Roluda/MachtGoethe/Info_Datasheets/nano_pinout.jpg

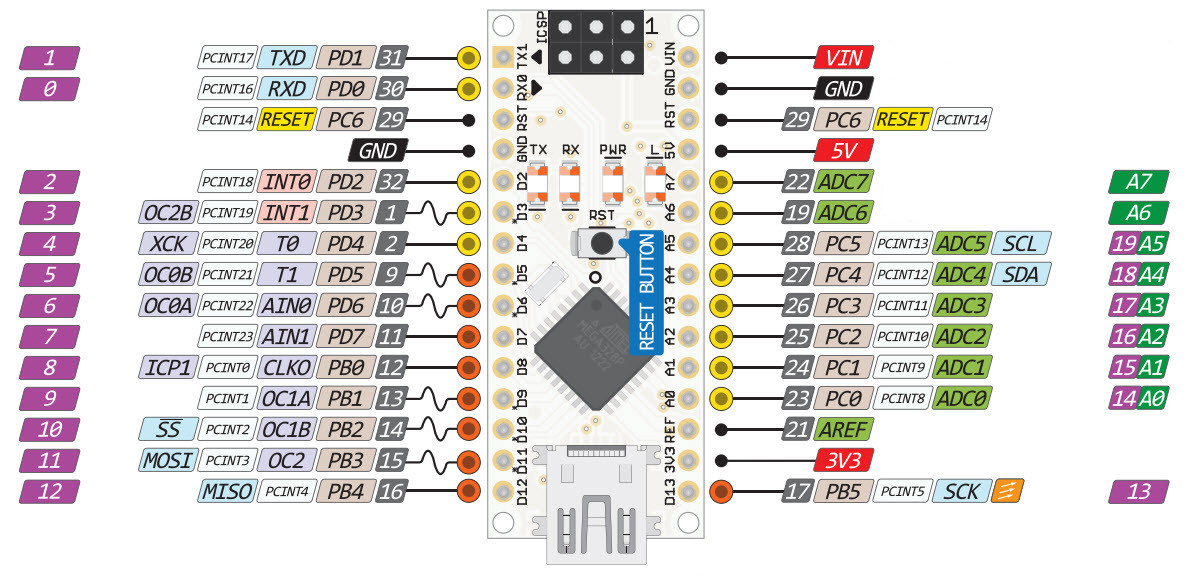
Info_Datasheets/nano_pinout.jpg
