Roluda/MachtGoethe/README.md

# MachtGoethe
Arduino Sketche und Schaltpläne für "Escape the Library"

Die Grundstruktur des Buches ist im Buch_Schaltplan.pdf abgebildet.

Mehr Details zu spezifischen Rätseln finden sich in den "schemes" Ordnern der Rätsel.

Die Sketche für die Arduinos sind in den "firmware" Ordnern zu finden.
