Roluda/MachtGoethe/Seite01_RFID-Edelsteindetektor/Kuehlkoerper/RFID_KK.pdf

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

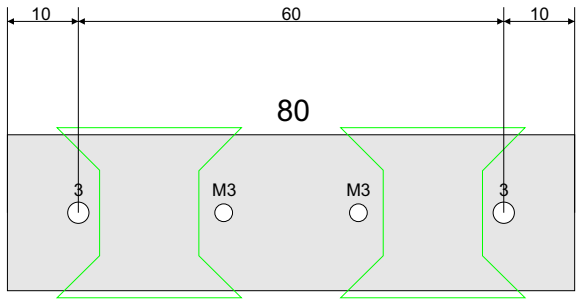
[picture p2: figure]
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
