Roluda/MachtGoethe/Seite01_RFID-Edelsteindetektor/schematics/Goethe_RFID_partlist.xls

 | Partlist
 | Exported from Goethe_RFID_v2.sch at 17.01.2020 02:36
 | EAGLE Version 7.7.0 Copyright (c) 1988-2016 CadSoft |  |  | Device count | 8
Count | Value | Device | Package | Order no | Total count
7 | 10u | C-EUC1206 | C1206 | X7R-G1206 10/25 | 56 | vorhanden
1 | SS1XL | SS1XL | SUB_SMA | SS 12L | 8 | vorhanden
1 | LM1086 | VREG_TO220L_A | TO220L1 | LM 1086 CT-ADJ | 8
1 | LM2937 | VREG_SOT223 | SOT223 | LM 2937 IMP-3.3 | 8
1 | PINHD-1X3/90 | 1X03/90 | pinhead | SL 1x50w 2,54 | 8
6 | LED3MM_red | LED3MM | led | LED 3mm 2ma rt | 48
1 | LED3MM_green | LED3MM | led | LED 3mm 2ma gn | 8
1 | ARDUINO_R3_SMALL | ARDUINO_R3_SMALL | ARDUINOR3_SMALL | Aliexpress | 8
3 | IRF8910PBF | IRF8910PBF | SO-08 | IRF8910PBF | 24
8 | 1k | R-EU_R0805 | R0805 | SMD-0805 1,00k | 64
24 | 20/0.125W | R-EU_R0805 | R0805 | RND 0805 1 20 | 192
3 | 22k | R-EU_R0805 | R0805 | SMD-0805 22,0k | 24
1 | 100 | R-EU_R0805 | R0805 | SMD-0805 100 | 8
10 | 220 | R-EU_R0805 | R0805 | SMD-0805 220 | 80
1 | 860 | R-EU_R0805 | R0805 | SMD-0805 860 | 8
1 | 0 | R-EU_R0805 | R0805 | SMD-0805 0,00 | 8
1 | ML16 | ML16 | con-harting-ml | WSL 16G | 8
1 | ML26 | ML26 | con-harting-ml | WSL 26G | 8
1 | 12V | supply | W237-02P | ASP 02 5 | 8
1 |  |  |  | AKL 330-02 | 8
5 |  |  |  | WSL 16W | 40
6 |  |  |  | PFL 16 | 48
1 |  |  |  | PFL 26 | 8
6 | 1n |  | bedrahtet 5mm | NPO-5 1,0N | 48
1 | Flachbandkabel |  |  | AWG 28-16G 10M
