Roluda/MachtGoethe/Seite01_RFID-Edelsteindetektor/Kuehlkoerper/RFID_KK.dxf

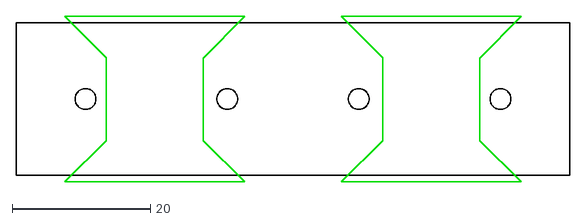
[picture p3: CAD file, 2020-01-26]
Seite01_RFID-Edelsteindetektor/Kuehlkoerper/RFID_KK.dxf
80.0 x 24.0
