Roluda/MachtGoethe/Seite01_Finale/schematics/Finale_Schaltplan.pdf

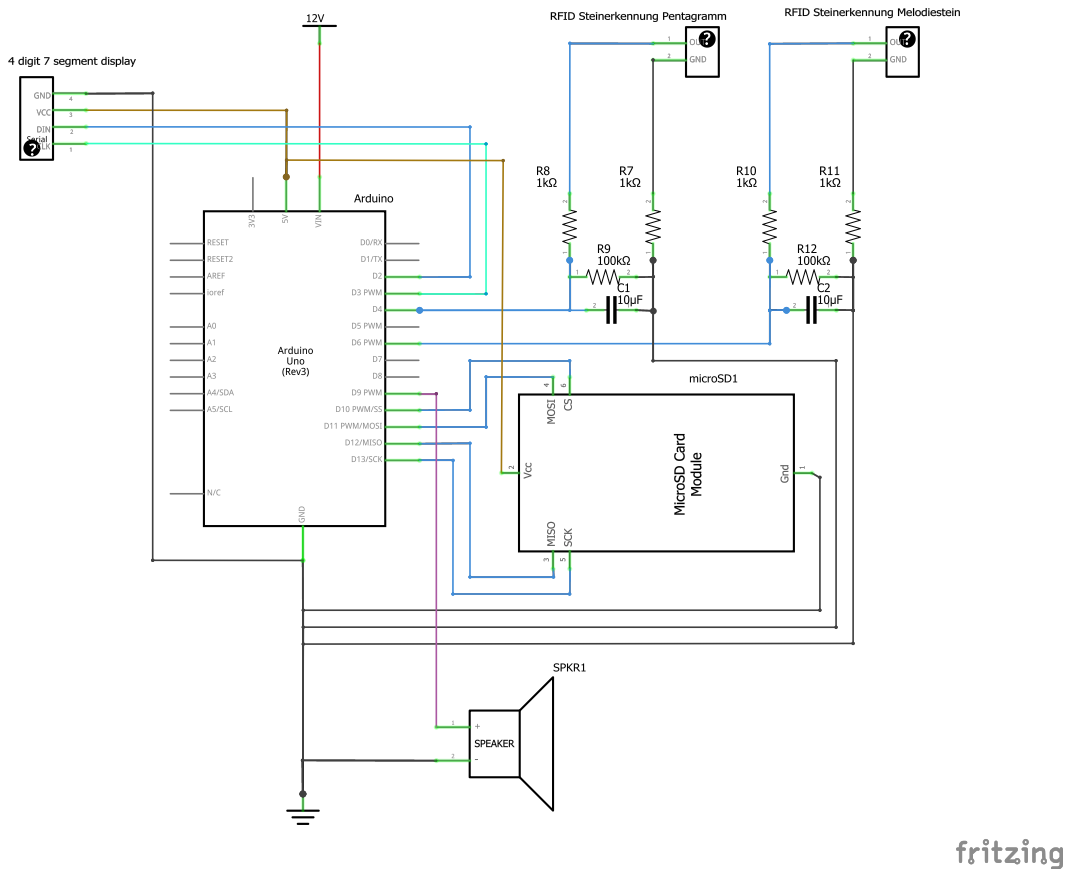
[picture p4: page 1]
