Roluda/MachtGoethe/Seite02_Klopfpuzzle/schematics/KlopfpuzzleSchaltplan.pdf

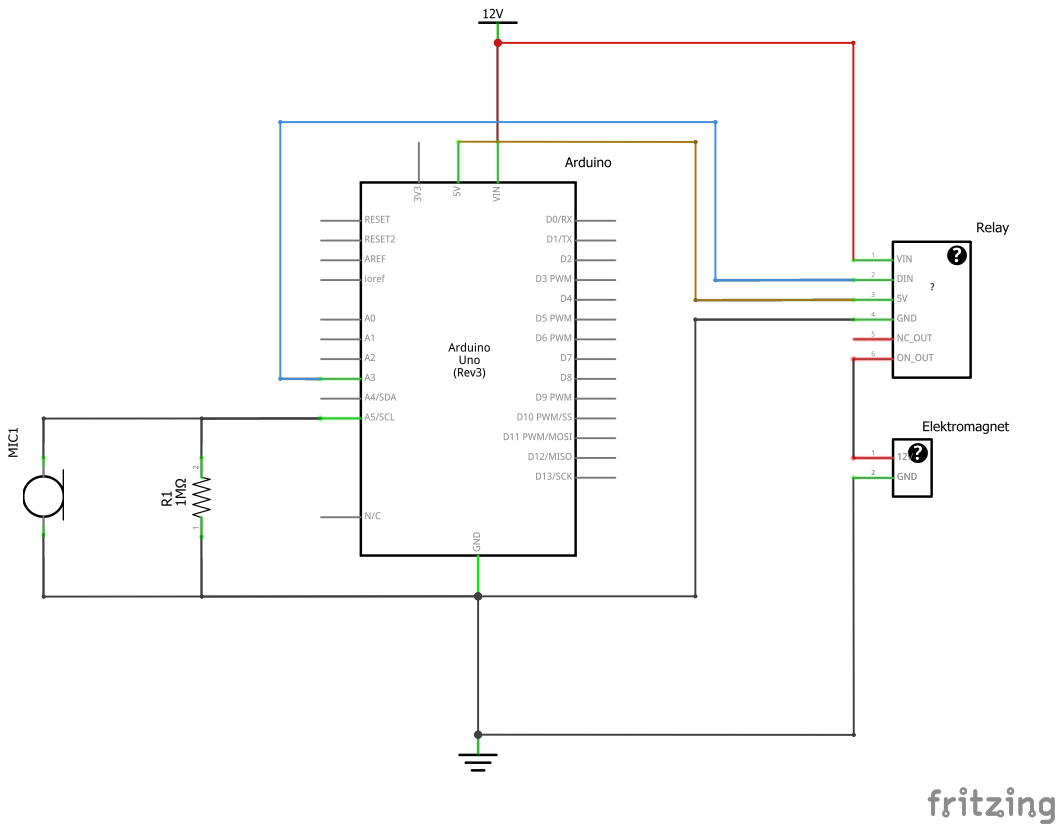
[picture p5: page 1]
