Roluda/MachtGoethe/Seite03_Farbkreispuzzle/schematics/Farbkreispuzzle_Schaltplan.pdf

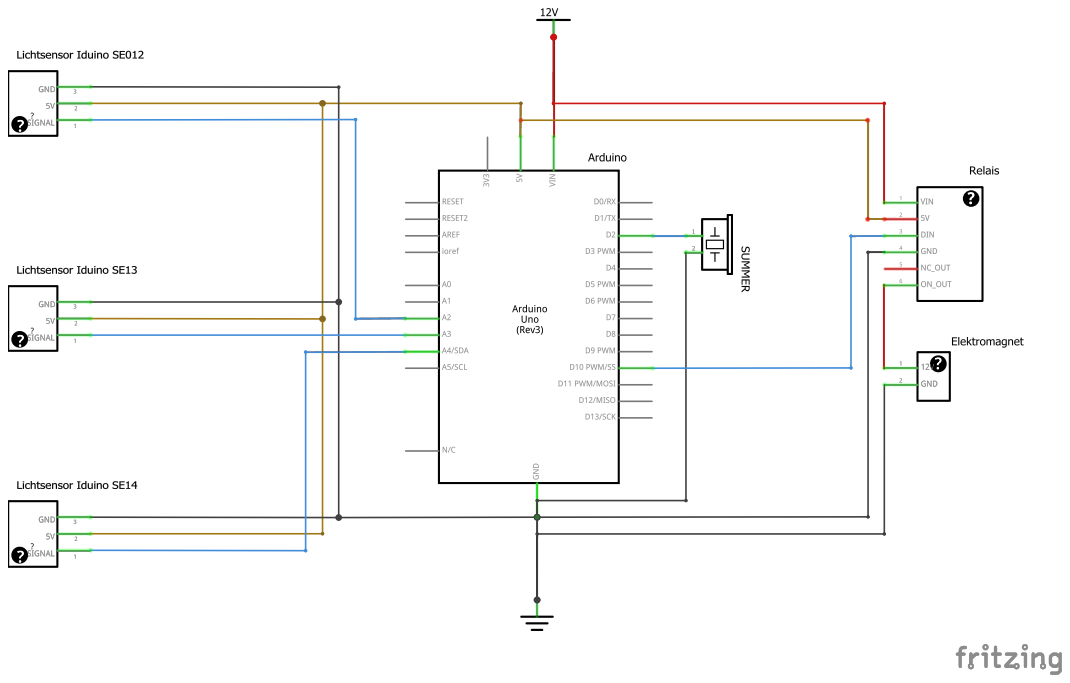
[picture p6: page 1]
