Roluda/MachtGoethe/Seite04_Endoskoppuzzle/schematics/Endoskoppuzzle_Schaltplan.pdf

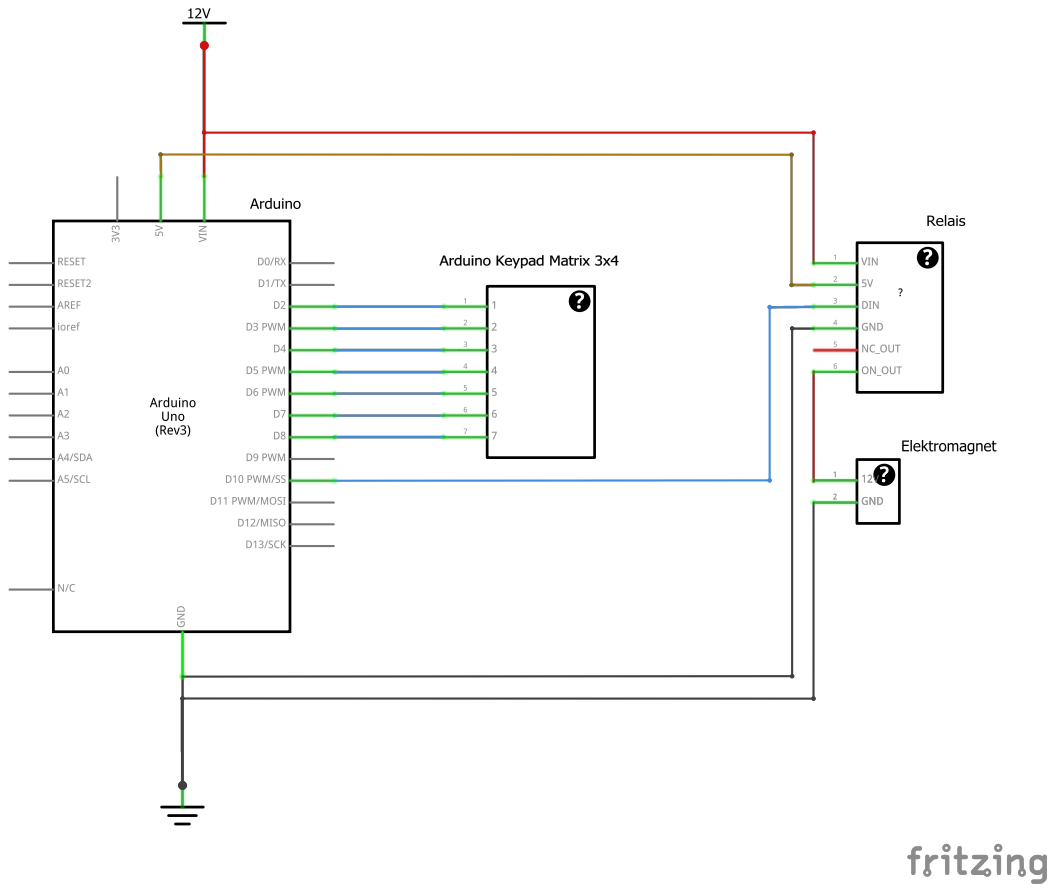
[picture p7: page 1]
