Roluda/MachtGoethe/Seite06_Steckpuzzle/schematics/Steckpuzzle_Schaltplan.pdf

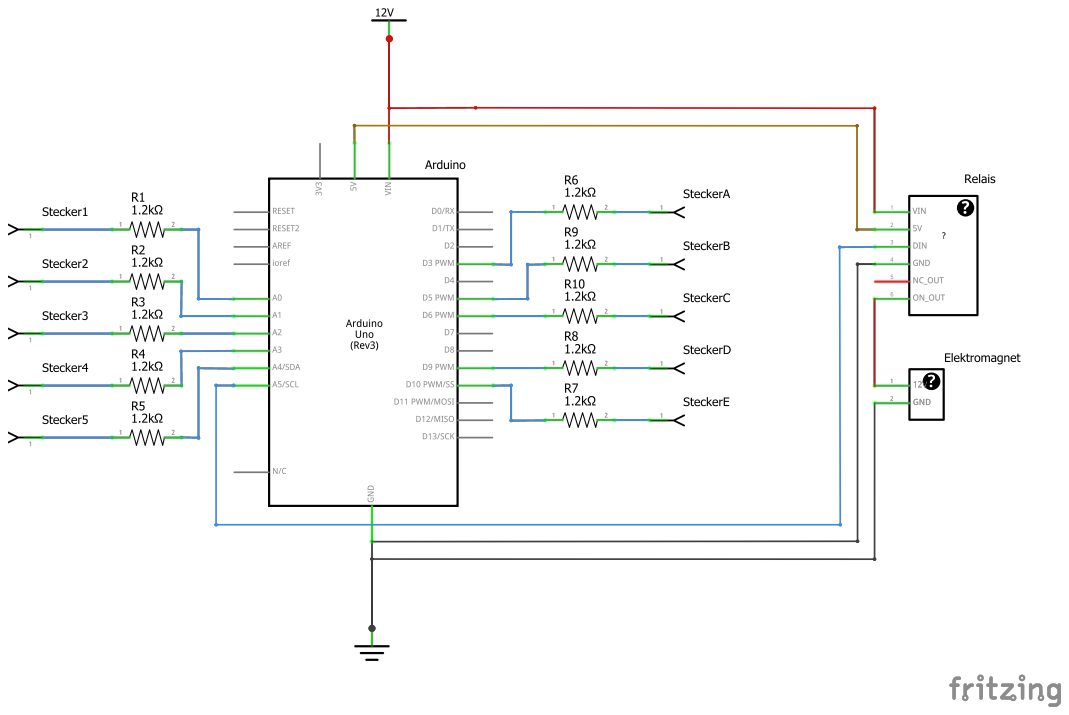
[picture p8: page 1]
