Roluda/MachtGoethe/Seite07_Melodiepuzzle/schematics/Melodiepuzzle_Schaltplan.pdf

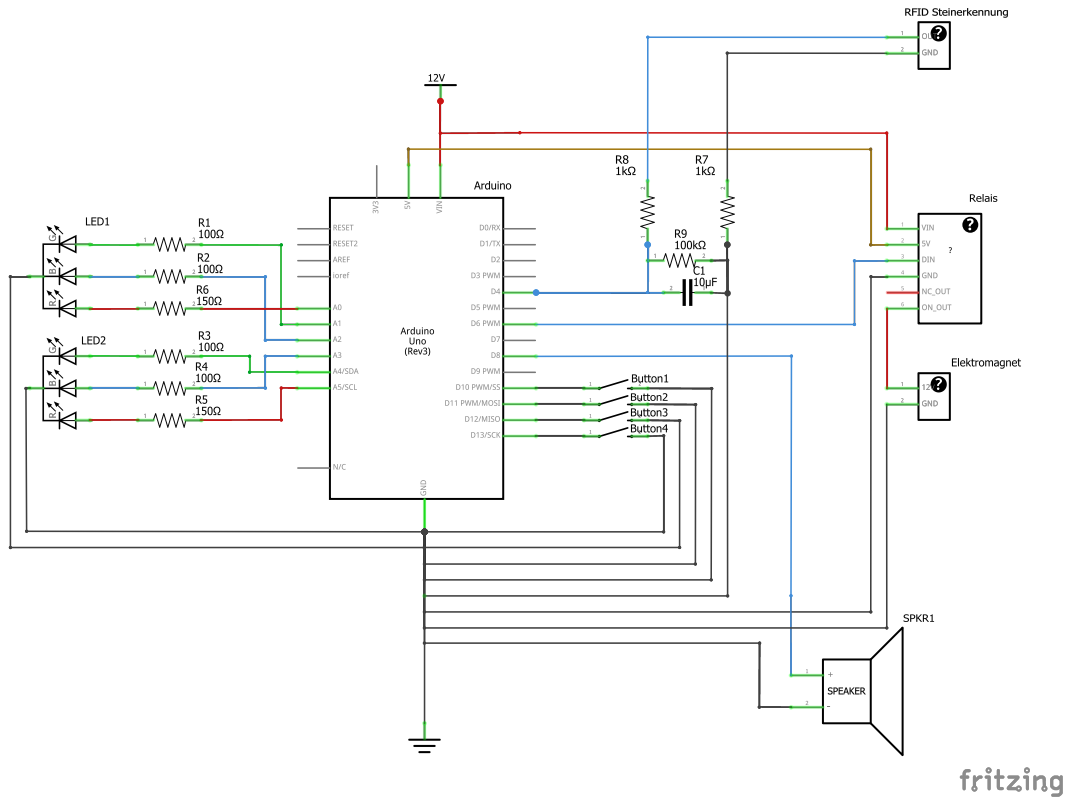
[picture p9: page 1]
