Roluda/MachtGoethe/Seite08_RFID-Finalstein/schematics/ReadAndWriteLastStone_Schaltplan.pdf

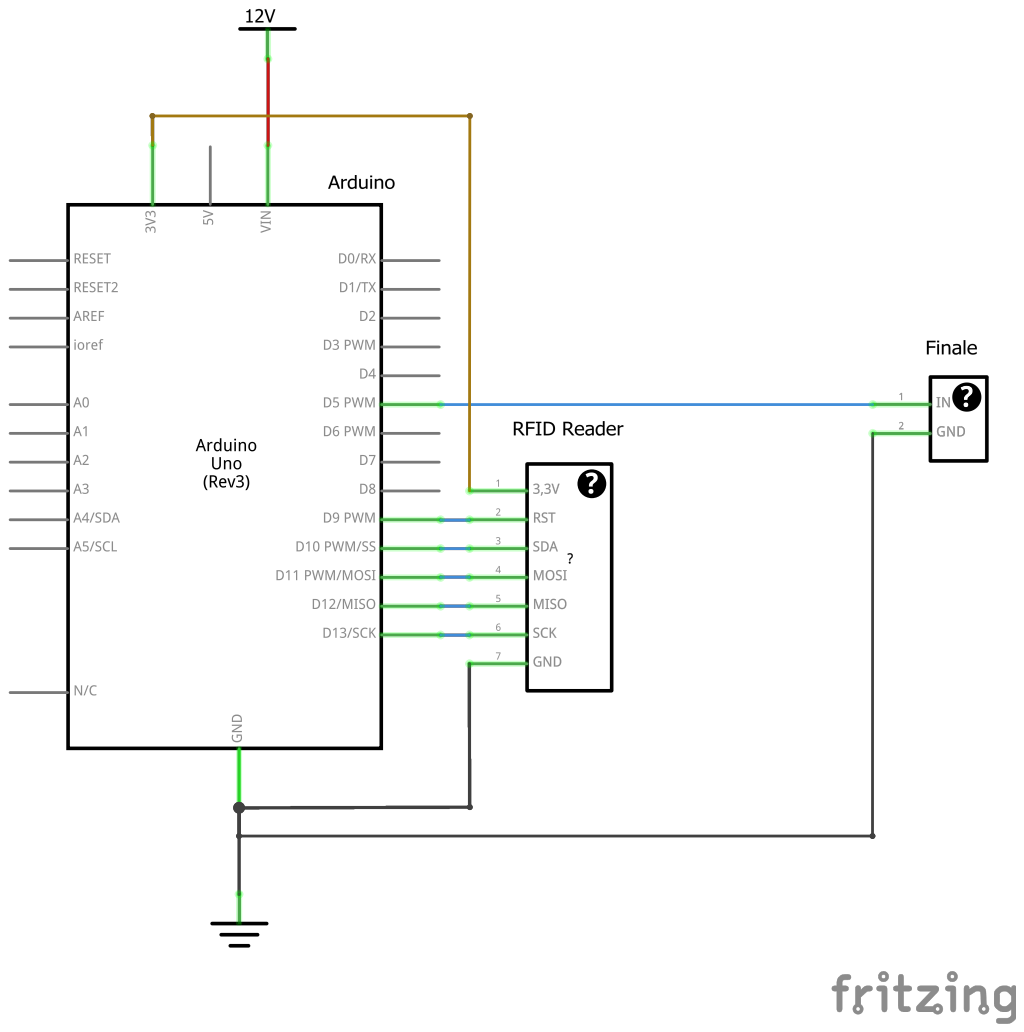
[picture p10: page 1]
