Roluda/MachtGoethe/Buch_Schaltplan.pdf

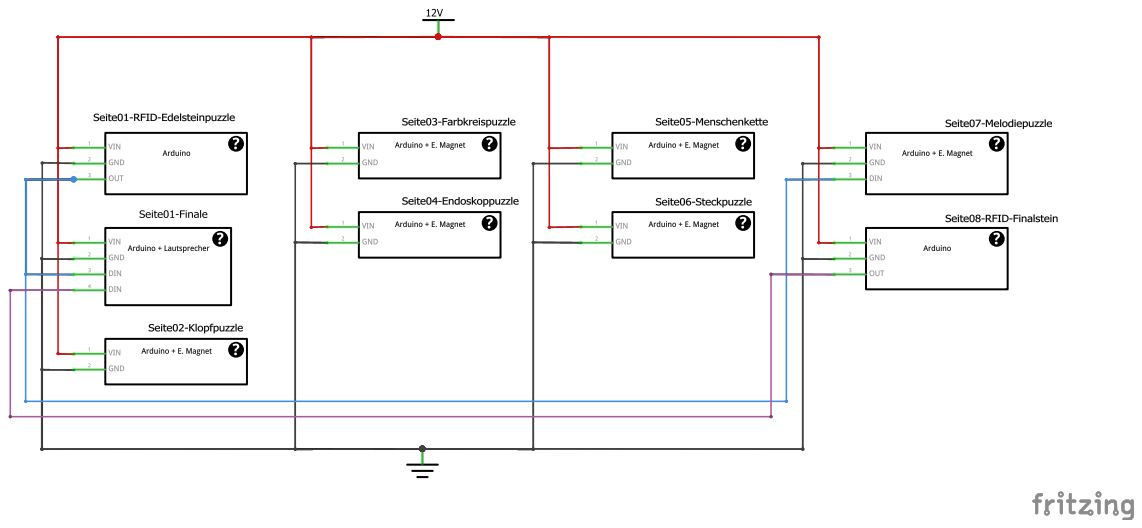
[picture p12: page 1]
