Roluda/MachtGoethe/(list of files, drawings)

Other design files:
Buch.fzz
Seite01_Finale/schematics/Finale.fzz
Seite03_Farbkreispuzzle/schematics/Farbkreispuzzle.fzz
Seite04_Endoskoppuzzle/schematics/Endoskoppuzzle.fzz
Seite06_Steckpuzzle/schematics/Steckpuzzle.fzz
Seite07_Melodiepuzzle/schematics/Melodiepuzzle.fzz
Seite08_RFID-Finalstein/schematics/ReadAndWriteLastStone.fzz
