Roluda/MachtGoethe/RFID_Prototyp/schematics/Goethe_RFID_v2.sch

## EAGLE design RFID_Prototyp/schematics/Goethe_RFID_v2.sch (2020-01-17)

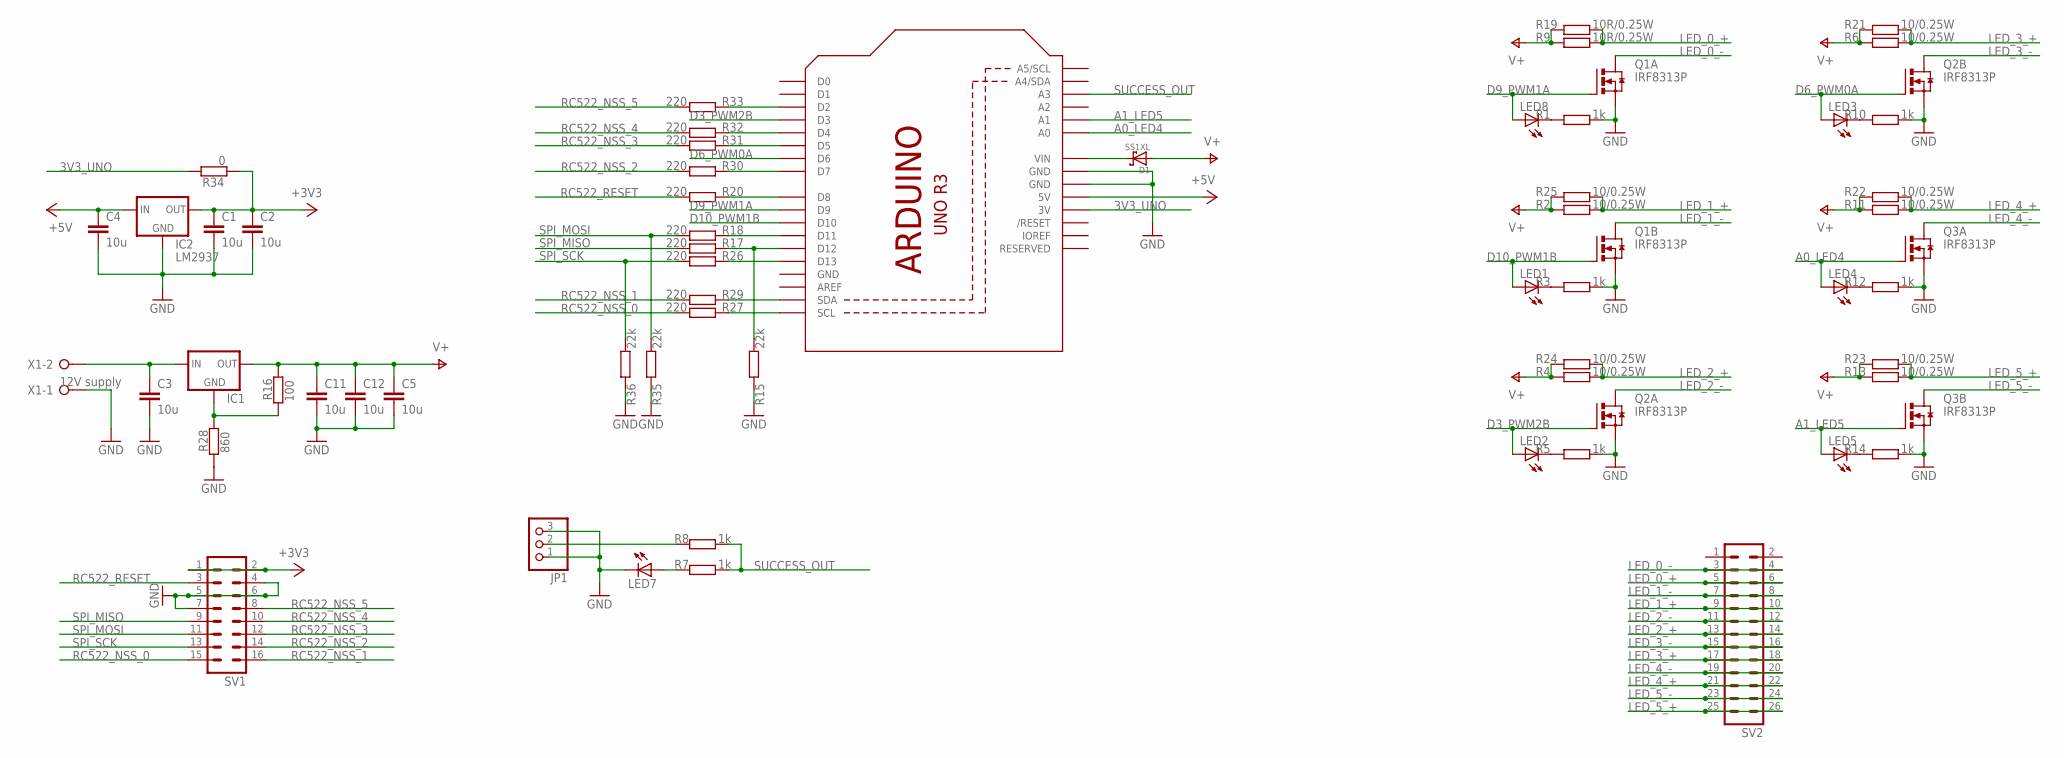
[picture p16: schematic Goethe_RFID_v2.sch]

Parts:
C1, C2, C3, C4, C5, C11, C12: 10u; C1206
D1: SS1XL; SUB_SMA
IC1: VREG_TO220L_A; TO220L1
IC2: LM2937; SOT223
JP1: PINHD-1X3/90; 1X03/90
LED1, LED2, LED3, LED4, LED5, LED7, LED8: LED3MM
M1: ARDUINO_R3_SMALL; ARDUINOR3_SMALL
Q1, Q2, Q3: IRF8313P; SO-08
R1, R3, R5, R7, R8, R10, R12, R14: 1k; R0805
R2, R4, R6, R11, R13, R21, R22, R23, R24, R25: 10/0.25W; R0805
R9, R19: 10R/0.25W; R0805
R15, R35, R36: 22k; R0805
R16: 100; R0805
R17, R18, R20, R26, R27, R29, R30, R31, R32, R33: 220; R0805
R28: 860; R0805
R34: 0; R0805
SV1: ML16
SV2: ML26
X1: 12V supply; W237-132

Connections:
3V3_UNO: M1.3V, R34.1
+3V3: C1.1, C2.1, IC2.3 (OUT), R34.2, SV1.1, SV1.2
+5V: C4.1, IC2.1 (IN), M1.5V
A0_LED4: LED4.A, M1.A0, Q3.4 (G)
A1_LED5: LED5.A, M1.A1, Q3.2 (G)
D3_PWM2B: LED2.A, M1.D3, Q2.4 (G)
D6_PWM0A: LED3.A, M1.D6, Q2.2 (G)
D9_PWM1A: LED8.A, M1.D9, Q1.4 (G)
D10_PWM1B: LED1.A, M1.D10, Q1.2 (G)
GND: C1.2, C2.2, C3.2, C4.2, C5.2, C11.2, C12.2, IC2.2 (GND), JP1.1, JP1.3, LED7.K (C), M1.GND@1 (GND), M1.GND@2 (GND), Q1.1 (S), Q1.3 (S), Q2.1 (S), Q2.3 (S), Q3.1 (S), Q3.3 (S), R1.1, R3.1, R5.1, R10.1, R12.1, R14.1, R15.2, R28.2, R35.2, R36.2, SV1.4, SV1.5, SV1.6, SV1.7, X1.1
LED_0_+: R9.1, R19.1, SV2.5, SV2.6
LED_0_-: Q1.5 (D), SV2.3, SV2.4
LED_1_+: R2.1, R25.1, SV2.9, SV2.10
LED_1_-: Q1.7 (D), SV2.7, SV2.8
LED_2_+: R4.1, R24.1, SV2.13, SV2.14
LED_2_-: Q2.5 (D), SV2.11, SV2.12
LED_3_+: R6.1, R21.1, SV2.17, SV2.18
LED_3_-: Q2.7 (D), SV2.15, SV2.16
LED_4_+: R11.1, R22.1, SV2.21, SV2.22
LED_4_-: Q3.5 (D), SV2.19, SV2.20
LED_5_+: R13.1, R23.1, SV2.25, SV2.26
LED_5_-: Q3.7 (D), SV2.23, SV2.24
unnamed: LED1.K (C), R3.2
unnamed: M1.D12, R15.1, R17.2
unnamed: LED2.K (C), R5.2
unnamed: LED3.K (C), R10.2
unnamed: LED4.K (C), R12.2
unnamed: LED5.K (C), R14.2
unnamed: M1.D13, R26.2
unnamed: LED7.A, R7.2
unnamed: C3.1, IC1.3 (IN), X1.2
unnamed: LED8.K (C), R1.2
unnamed: IC1.1 (GND), R16.2, R28.1
unnamed: M1.D11, R18.2
unnamed: M1.D8, R20.2
unnamed: M1.SCL, R27.2
unnamed: M1.SDA, R29.2
unnamed: M1.D2, R33.2
unnamed: M1.D4, R32.2
unnamed: M1.D5, R31.2
unnamed: M1.D7, R30.2
unnamed: D1.C, M1.VIN
RC522_NSS_0: R27.1, SV1.15
RC522_NSS_1: R29.1, SV1.16
RC522_NSS_2: R30.1, SV1.14
RC522_NSS_3: R31.1, SV1.12
RC522_NSS_4: R32.1, SV1.10
RC522_NSS_5: R33.1, SV1.8
RC522_RESET: R20.1, SV1.3
SPI_MISO: R17.1, SV1.9
SPI_MOSI: R18.1, R35.1, SV1.11
SPI_SCK: R26.1, R36.1, SV1.13
SUCCESS_OUT: M1.A3, R7.1, R8.1
SUCCESS_OUT_: JP1.2, R8.2
V+: C5.1, C11.1, C12.1, D1.A, IC1.2 (OUT), R2.2, R4.2, R6.2, R9.2, R11.2, R13.2, R16.1, R19.2, R21.2, R22.2, R23.2, R24.2, R25.2
