Roluda/MachtGoethe/Seite05_Menschenkette/schematics/Goethe_Stromfluss.sch

## EAGLE design Seite05_Menschenkette/schematics/Goethe_Stromfluss.sch (2020-02-06)

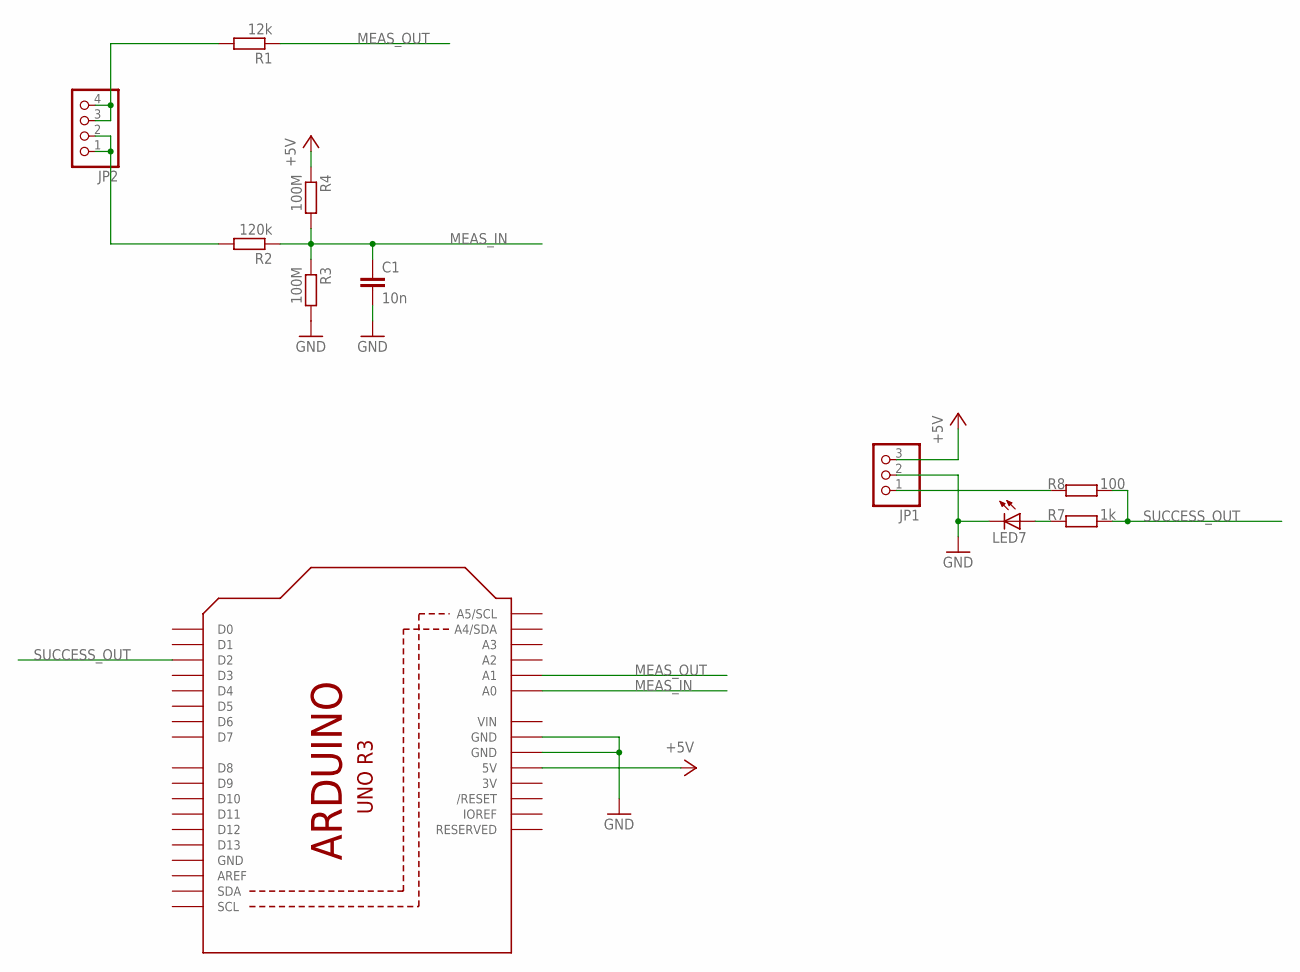
[picture p17: schematic Goethe_Stromfluss.sch]

Parts:
C1: 10n; C025-025X050
JP1: PINHD-1X3/90; 1X03/90
JP2: PINHD-1X4/90; 1X04/90
LED7: LED3MM
M1: ARDUINO_R3_SMALL; ARDUINOR3_SMALL
R1: 12k; 0204/7
R2: 120k; 0207/10
R3: 100M; 0204/7
R4: 100M; 0207/10
R7: 1k; 0204/7
R8: 100; 0207/12

Connections:
+5V: JP1.3, M1.5V, R4.1
GND: C1.2, JP1.2, LED7.K (C), M1.GND@1 (GND), M1.GND@2 (GND), R3.2
MEAS_IN: C1.1, M1.A0, R2.1, R3.1, R4.2
MEAS_OUT: M1.A1, R1.1
unnamed: JP2.3, JP2.4, R1.2
unnamed: JP1.1, R8.2
unnamed: JP2.1, JP2.2, R2.2
unnamed: LED7.A, R7.2
SUCCESS_OUT: M1.D2, R7.1, R8.1
