Roluda/MachtGoethe/(commit log)

2019-11-20 Add functionality for: electro magnets, win signal
2019-11-20 Add funtionality for magnet box
2019-11-26 Add support for box and locking magnet
2019-12-06 Working RFID detection with 6 readers
    [Goethe_RFID.sch]
2019-12-16 Faster main-loop without hard-resetting the readers; Set LED outputs according to detected channels
    [rfid_detect.ino]
2019-12-22 Test sketches for readers and LED
2019-12-22 Change control board to Arduino Uno; Add LED drivers
2020-01-17 New PCB for RFID controller
    [Goethe_RFID_v2.brd, Goethe_RFID_v2.sch]
2020-01-17 Restructure Project
    [Goethe_RFID.sch, Goethe_RFID_v2.brd, Goethe_RFID_v2.sch]
2020-01-19 Add schemes for all puzzles
    [Buch.fzz, Endoskoppuzzle.fzz, Farbkreispuzzle.fzz, Finale.fzz, Melodiepuzzle.fzz, ReadAndWriteLastStone.fzz, Steckpuzzle.fzz]
2020-01-26 Add RFID lib to repo; Adjust LED regulator voltage; Split RFID firmware in fron/back versions
    [Goethe_RFID_partlist.xls, Goethe_RFID_v2.brd, Goethe_Stromfluss.sch, RFID_KK.dxf]
2020-02-06 RFID detector firmware for new shield v2; Detector firmware for last page with learnable UID
    [Goethe_Stromfluss.sch]
2020-02-11 Fix missing wire on signal LED4
    [Goethe_RFID_v2.brd, Goethe_RFID_v2.sch]
2020-02-11 Increase PWM frequency
2020-02-12 RGBA colors for backside LED
2020-02-14 Steckpuzzle can reopen after cables were plugged out
